NerdFlare/NerdFlareBadge25/pcb/NerdFlare25.kicad_pcb

## KiCad design pcb/NerdFlare25.kicad_pcb (2025-03-22)

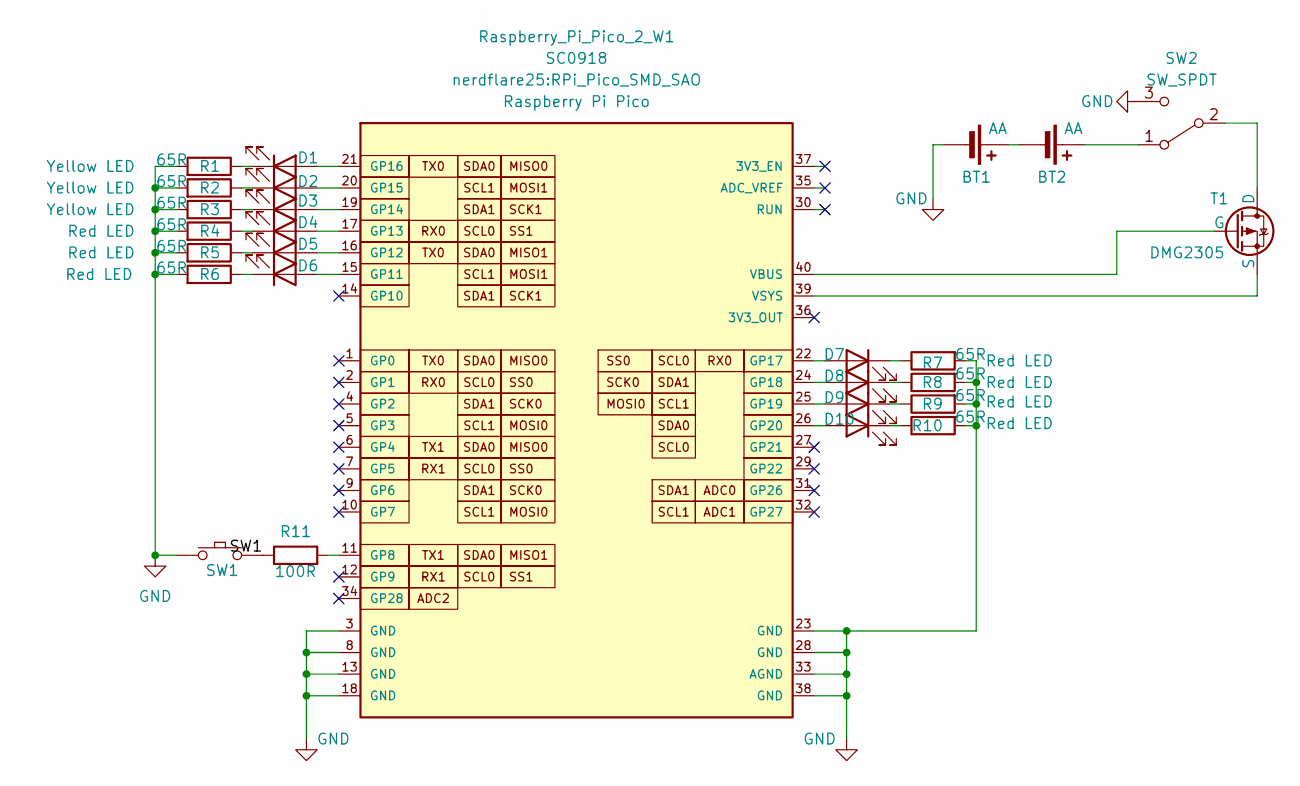
[picture p8: schematic NerdFlare25.kicad_sch]

Parts:
BT1, BT2: AA; BatteryHolder_Keystone_2460_1xAA_SAO
D1, D2, D3: Yellow LED; Wurth WL-SMSW Series SMT Mono-color Side view LED
D4, D5, D6, D7, D8, D9, D10: Red LED; Wurth WL-SMSW Series SMT Mono-color Side view LED
R1, R2, R3, R4, R5, R6, R7, R8, R9, R10: 65R; R_1206_3216Metric_Pad1.30x1.75mm_HandSolder
R11: 100R; R_1206_3216Metric_Pad1.30x1.75mm_HandSolder
Raspberry_Pi_Pico_2_W1: SC0918; RPi_Pico_SMD_SAO; PARTREV 1.6
SW1: SW_Push; SW_SPST_PTS645_SAO
SW2: SW_SPDT; SW_SPDT_PCM12
T1: DMG2305; SOT-23_SAO

Connections:
/SW1: R11.1, SW1.2; also elsewhere on the board
GND: BT1.2 (-), R1.2, R2.2, R3.2, R4.2, R5.2, R6.2, R7.2, R8.2, R9.2, R10.2, Raspberry_Pi_Pico_2_W1.3 (GND), Raspberry_Pi_Pico_2_W1.8 (GND), Raspberry_Pi_Pico_2_W1.13 (GND), Raspberry_Pi_Pico_2_W1.18 (GND), Raspberry_Pi_Pico_2_W1.23 (GND), Raspberry_Pi_Pico_2_W1.28 (GND), Raspberry_Pi_Pico_2_W1.33 (AGND), Raspberry_Pi_Pico_2_W1.38 (GND), SW1.1, SW2.3 (C); also elsewhere on the board
unnamed 3: D6.2 (A), Raspberry_Pi_Pico_2_W1.15 (GP11); also elsewhere on the board
unnamed 4: D5.2 (A), Raspberry_Pi_Pico_2_W1.16 (GP12); also elsewhere on the board
unnamed 5: D4.2 (A), Raspberry_Pi_Pico_2_W1.17 (GP13); also elsewhere on the board
unnamed 6: D3.2 (A), Raspberry_Pi_Pico_2_W1.19 (GP14); also elsewhere on the board
unnamed 7: D2.2 (A), Raspberry_Pi_Pico_2_W1.20 (GP15); also elsewhere on the board
unnamed 8: D1.2 (A), Raspberry_Pi_Pico_2_W1.21 (GP16); also elsewhere on the board
unnamed 9: D7.2 (A), Raspberry_Pi_Pico_2_W1.22 (GP17); also elsewhere on the board
unnamed 10: D8.2 (A), Raspberry_Pi_Pico_2_W1.24 (GP18); also elsewhere on the board
unnamed 11: D9.2 (A), Raspberry_Pi_Pico_2_W1.25 (GP19); also elsewhere on the board
unnamed 12: D10.2 (A), Raspberry_Pi_Pico_2_W1.26 (GP20); also elsewhere on the board
unnamed 13: Raspberry_Pi_Pico_2_W1.40 (VBUS), T1.1 (G); also elsewhere on the board
unnamed 14: Raspberry_Pi_Pico_2_W1.39 (VSYS), T1.2 (S); also elsewhere on the board
unnamed: BT1.1 (+), BT2.2 (-)
unnamed: BT2.1 (+), SW2.1 (A)
unnamed: D1.1 (K), R1.1
unnamed: D2.1 (K), R2.1
unnamed: D3.1 (K), R3.1
unnamed: D4.1 (K), R4.1
unnamed: D5.1 (K), R5.1
unnamed: D6.1 (K), R6.1
unnamed: D7.1 (K), R7.1
unnamed: D8.1 (K), R8.1
unnamed: D9.1 (K), R9.1
unnamed: D10.1 (K), R10.1
unnamed: R11.2, Raspberry_Pi_Pico_2_W1.11 (GP8)
unnamed: SW2.2 (B), T1.3 (D)

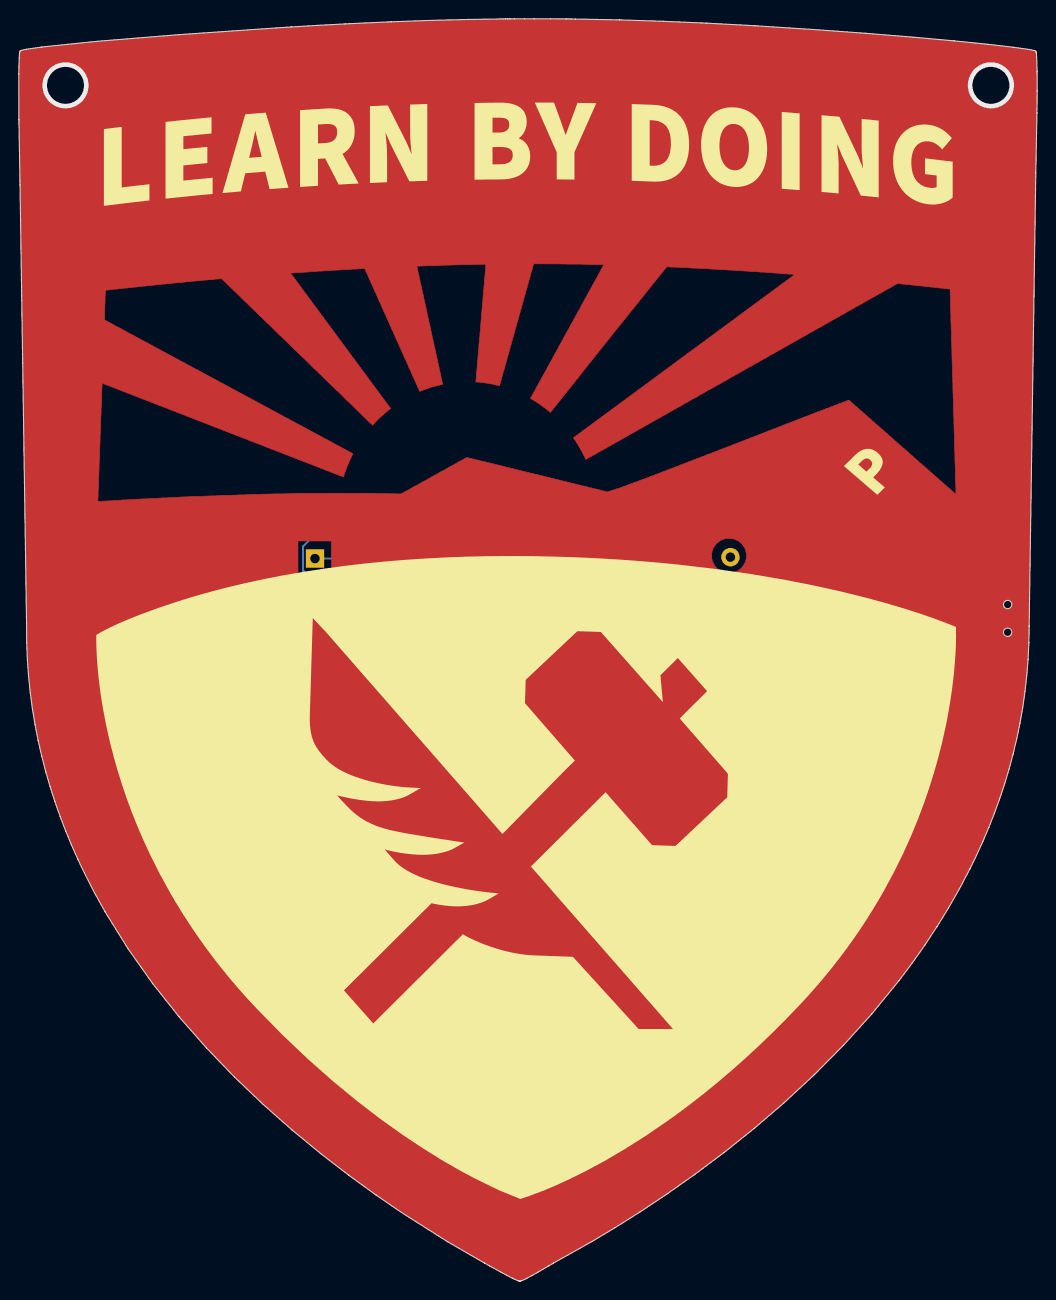
[picture p9: board NerdFlare25.kicad_pcb from above]

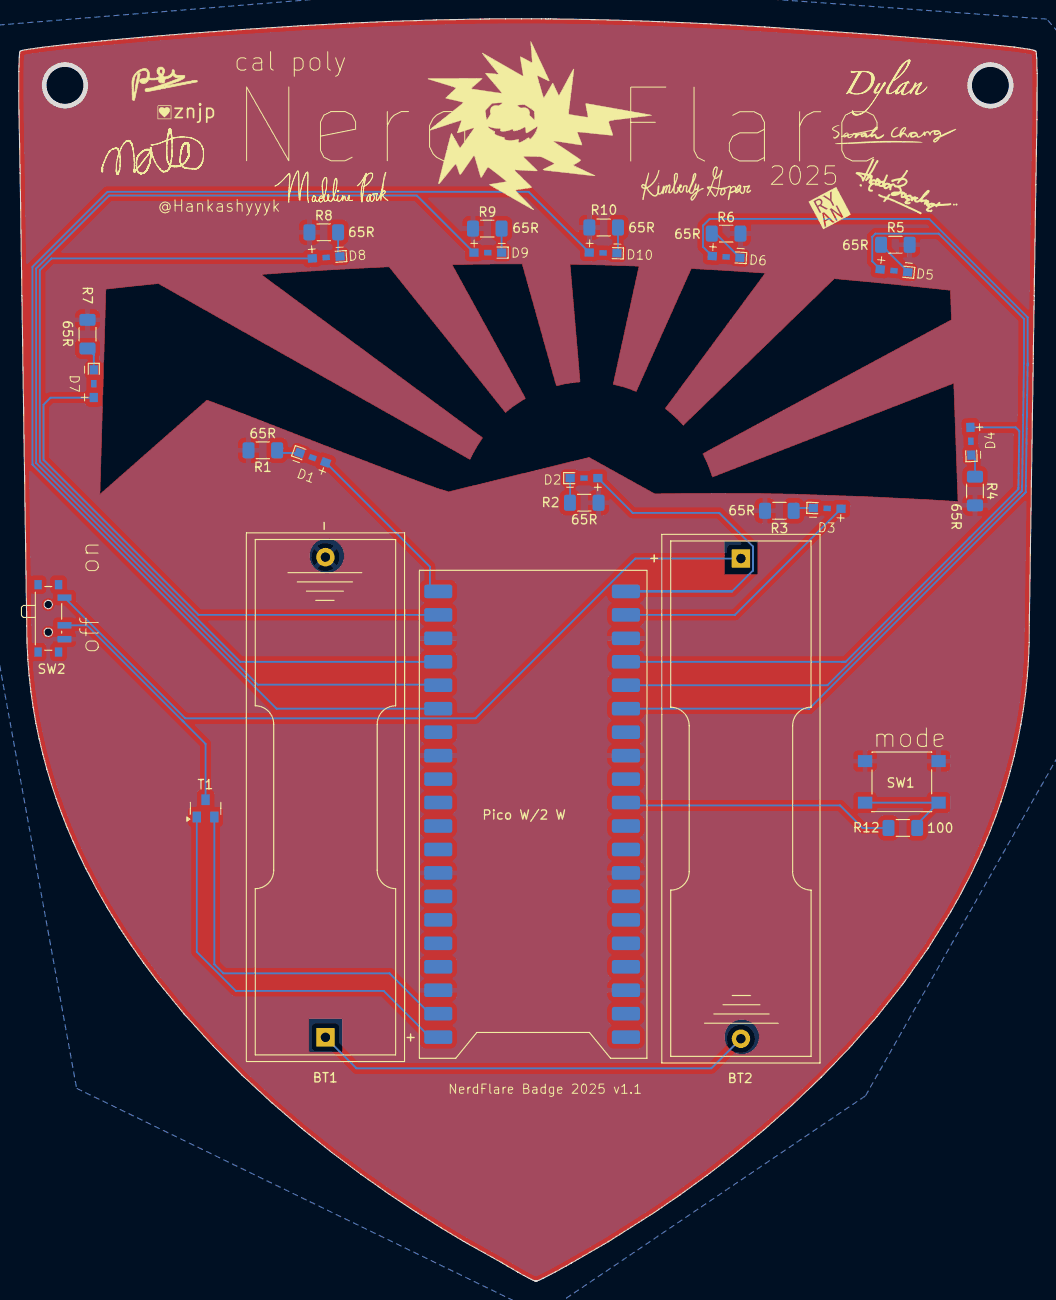
[picture p10: board NerdFlare25.kicad_pcb from below]

Board: 2 copper layers, 110.3 x 136.7 mm, 27 parts (27 on the bottom side), 28 nets.

Other parts of the board:
Pico W/2 W: SC0918; RPi_Pico_SMD_SAO
R12: 100; R_1206_3216Metric_Pad1.30x1.75mm_HandSolder

Their connections:
/SW1: R12.1; also elsewhere on the board
GND: Pico W/2 W.3 (GND), Pico W/2 W.8 (GND), Pico W/2 W.13 (GND), Pico W/2 W.18 (GND), Pico W/2 W.23 (GND), Pico W/2 W.28 (GND), Pico W/2 W.33 (AGND), Pico W/2 W.38 (GND); also elsewhere on the board
unnamed: Pico W/2 W.11 (GP8), R12.2
unnamed 3: Pico W/2 W.15 (GP11); also elsewhere on the board
unnamed 4: Pico W/2 W.16 (GP12); also elsewhere on the board
unnamed 5: Pico W/2 W.17 (GP13); also elsewhere on the board
unnamed 6: Pico W/2 W.19 (GP14); also elsewhere on the board
unnamed 7: Pico W/2 W.20 (GP15); also elsewhere on the board
unnamed 8: Pico W/2 W.21 (GP16); also elsewhere on the board
unnamed 9: Pico W/2 W.22 (GP17); also elsewhere on the board
unnamed 10: Pico W/2 W.24 (GP18); also elsewhere on the board
unnamed 11: Pico W/2 W.25 (GP19); also elsewhere on the board
unnamed 12: Pico W/2 W.26 (GP20); also elsewhere on the board
unnamed 13: Pico W/2 W.40 (VBUS); also elsewhere on the board
unnamed 14: Pico W/2 W.39 (VSYS); also elsewhere on the board
