NerdFlare/NerdFlareBadge25/pcb/guides/led_color_map.jpg

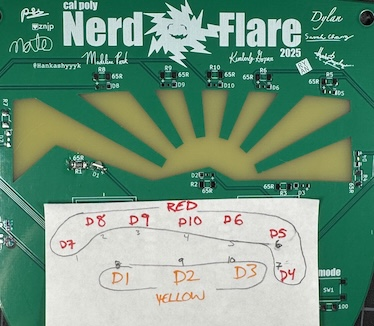
pcb/guides/led_color_map.jpg
