NerdFlare/NerdFlareBadge25/pcb/guides/solder_one_pad.jpg

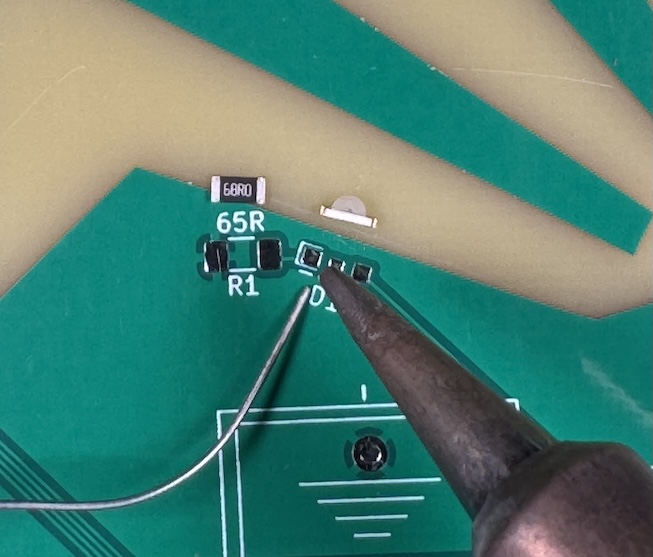
pcb/guides/solder_one_pad.jpg
