NerdFlare/NerdFlareBadge25/(commit log)

2025-01-16 Initial commit of the NerdFlare badge for 24-25. This is just a potential starting schematic.
    [NerdFlare25.kicad_pcb, NerdFlare25.kicad_sch]
2025-02-22 An initial board design and layout; added a symbol library for the badge; added symbol, footprint, and 3D model for Wurth side fire LED
    [NerdFlare25.kicad_pcb, NerdFlare25.kicad_sch]
2025-02-23 Moved some silk labels around.
    [NerdFlare25.kicad_pcb]
2025-02-28 This is v0; going to fab.
    [NerdFlare25.kicad_pcb, NerdFlare25.kicad_sch]
2025-03-14 This is prototype v0, sent to manufactuer.
    [NerdFlare25.kicad_pcb, NerdFlare25.kicad_sch]
2025-03-18 This is v1 sent to production at JLCPCB; removed status LED, determined final LED colors; added silkscreen sigantures.
    [NerdFlare25.kicad_pcb, NerdFlare25.kicad_sch]
2025-03-19 v1.1 flipped on the on/off switch label loll
    [NerdFlare25.kicad_pcb]
2025-03-22 Reorganized folders, added source code, and svgs. Added paste layer to Pico footprint.
    [NerdFlare25-BOM.csv, NerdFlare25.kicad_pcb, NerdFlare25.kicad_sch]
2025-03-27 Version 1.1; added a little more debuging messages; fixed a bug when passing the number of seen badges to randomBlink()
    [main.py, nerdflare25.py]
2025-04-05 assembly guide initial
2025-04-11 Version 1.2.1: Added a pulse mode (which is now default); users can get out of BLE blinky mode by pressing button; changed the BLE scan to not be active, which may slow things down.
